otisliddy/garden-irrigation/(commit log)

2026-06-13 Implement option B expiry-based shadow valve commands
2026-06-13 Dashboard/Charts UI improvements: ADC→moisture%, click legend, merged Valves+Usage, remove battery%, thicker bars
2026-06-13 Zone cards equal height with buttons aligned via flex column + margin-top auto
2026-06-13 Track Lambda handler sources (were wrongly ignored by *.js); fix config GET to merge desired over reported
2026-06-14 Sync valve state to shadow on every change; fix mode label; rename valve sources app/button
    [garden-irrigation.ino]
2026-06-14 Rotate button pins to match physical wiring (A=21, B=13, Poly=14)
2026-06-14 Update wiring diagram button pins to match rotation (A=21, B=13, Poly=14)
2026-06-16 Fix MQTT feedback loop causing ~18 msg/s shadow storm
    [garden-irrigation.ino]
2026-06-23 Track PWA icon PNGs (exclude from root *.png ignore)
2026-06-23 Clear stale valve commands by deleting desired zone, not writing open:false (was cancelling auto watering)
2026-06-28 Clean up chart x-axis: numeric time axis with clock-aligned ticks
2026-06-28 Bound manual override: close valve on expiry + make re-arm idempotent (FW 2.1.3)
2026-06-28 Refactor watering control into one resolver; clear cap-fault on daily reset; prune comments (FW 2.1.4)
    [garden-irrigation.ino]
2026-06-28 Use RTC wall-clock for timers (fix button-wake drift) + report fault reason/zone (FW 2.1.5)
    [garden-irrigation.ino]
